poy74fl/Neva/docs/plaque_palpage.jpg

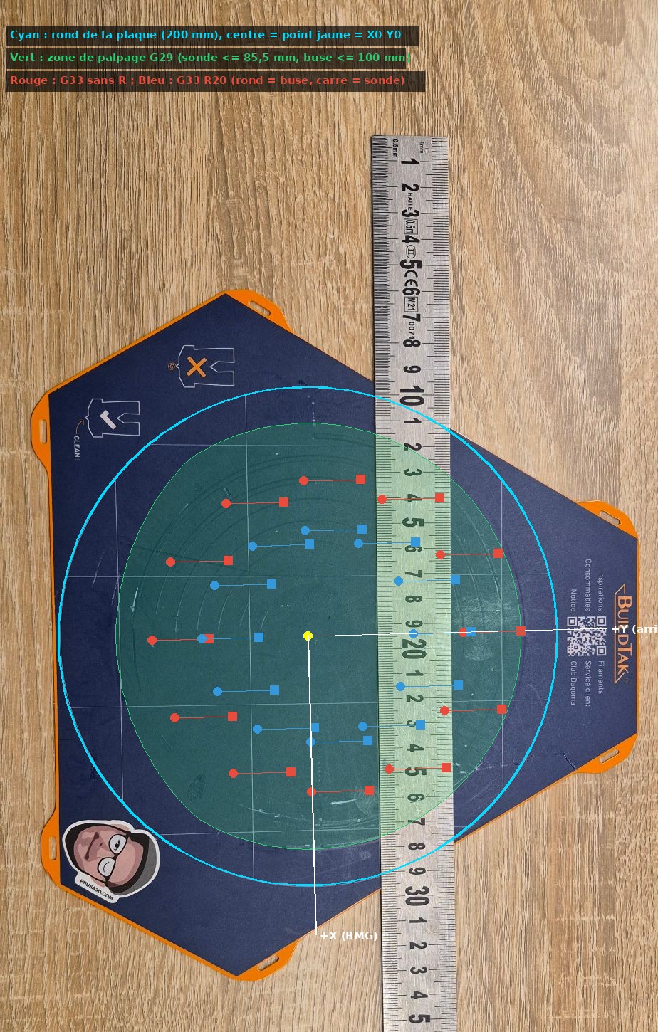
docs/plaque_palpage.jpg
