poy74fl/Neva/docs/superpinda_sur_carte.png

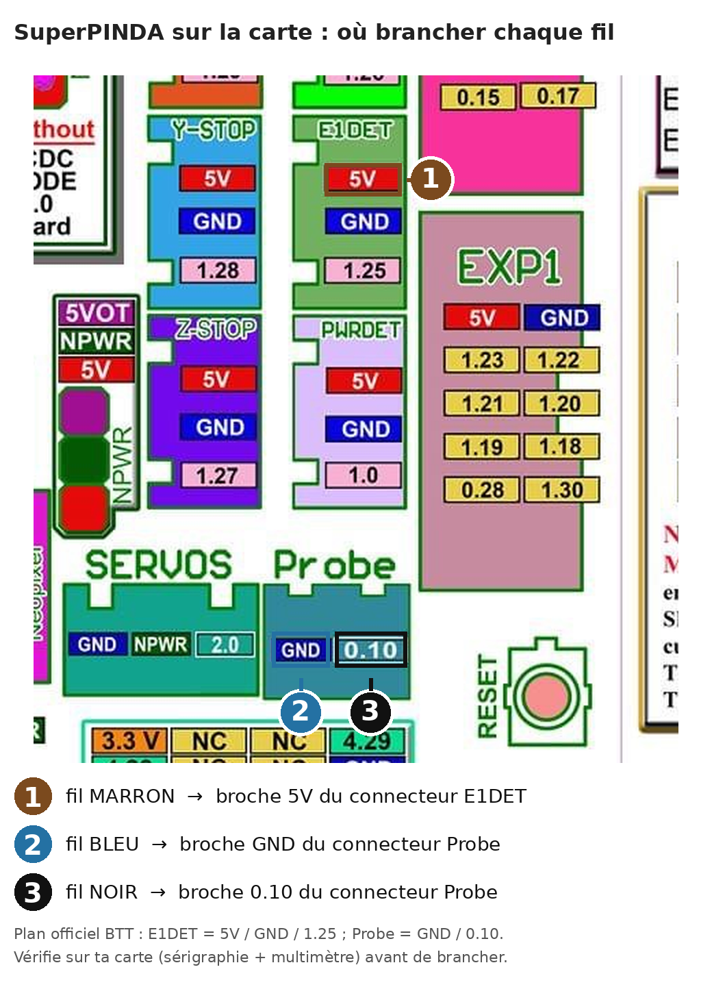
docs/superpinda_sur_carte.png
