poy74fl/Neva/docs/bootscreen_apercu.png

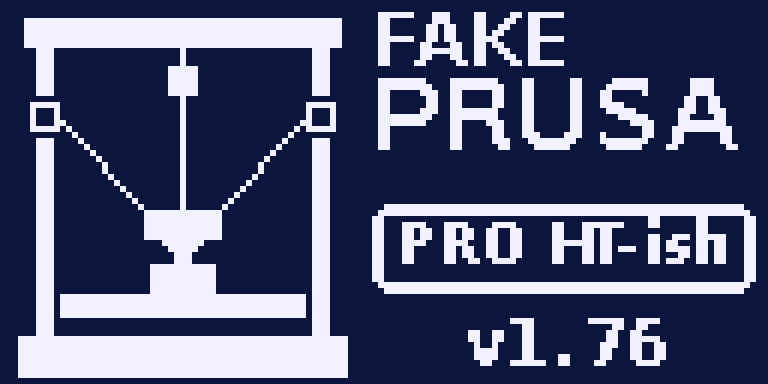
docs/bootscreen_apercu.png
