poy74fl/Neva/docs/mesures_rayon_delta.png

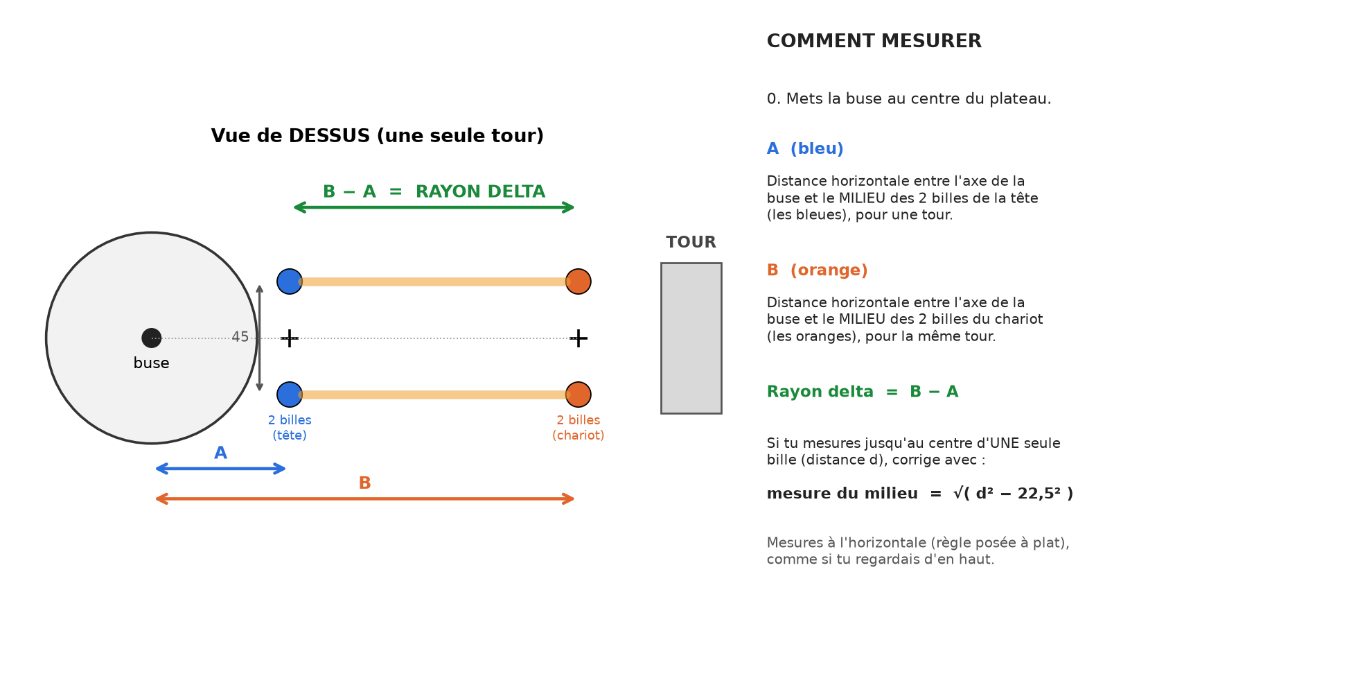
docs/mesures_rayon_delta.png
