poy74fl/Neva/docs/plan_cablage_skr14.png

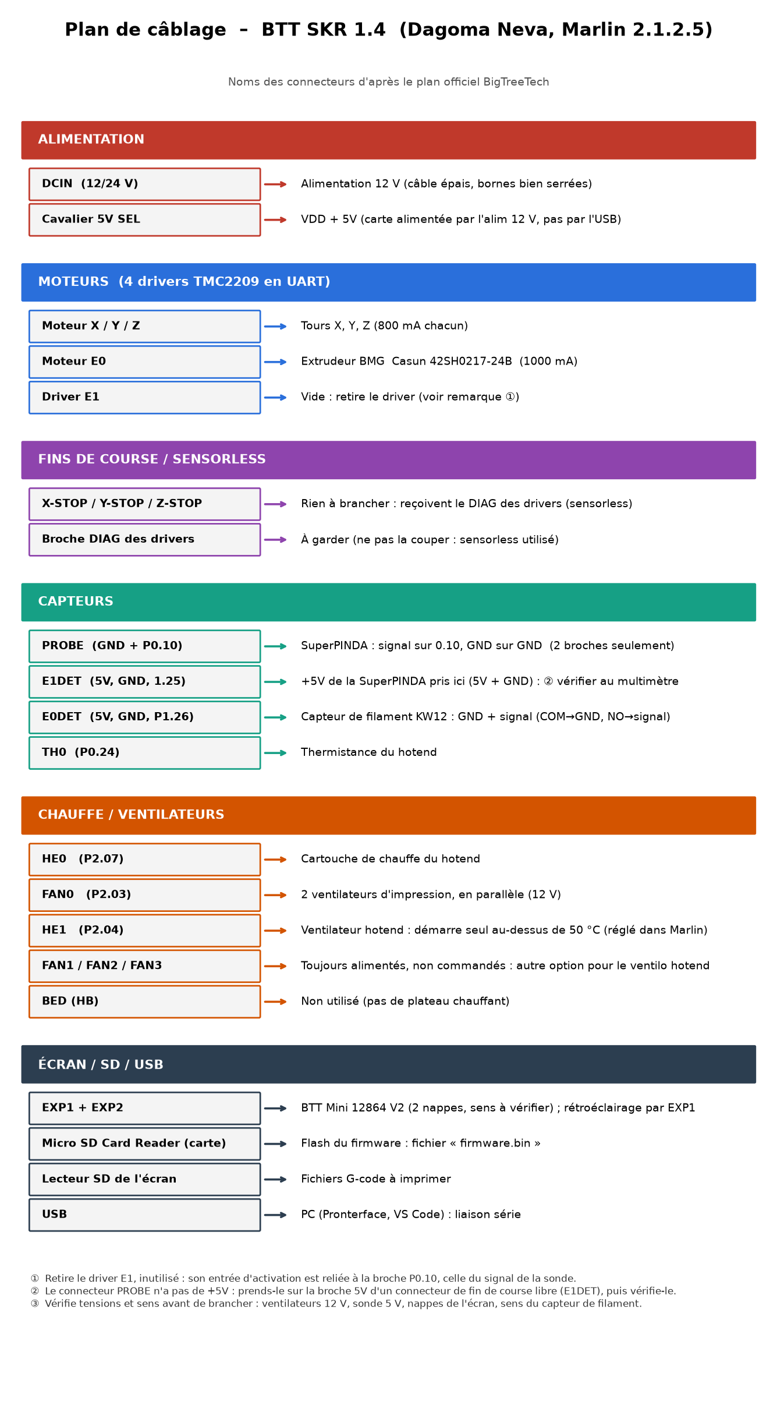
docs/plan_cablage_skr14.png
