poy74fl/Neva/docs/schema_sonde_buse.png

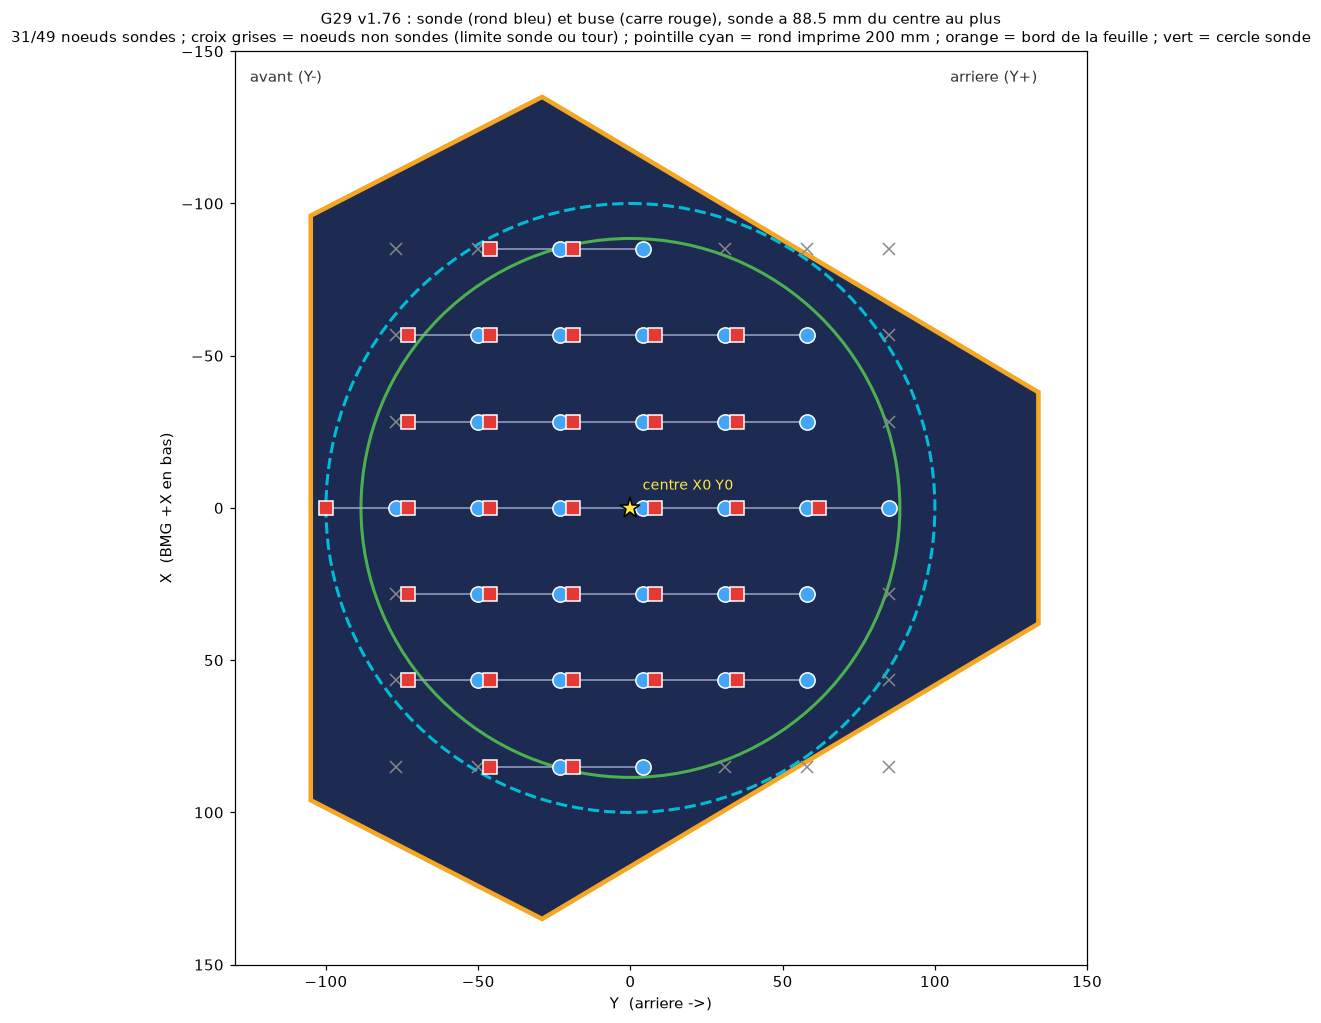
docs/schema_sonde_buse.png
