poy74fl/Neva/docs/schema_superpinda.png

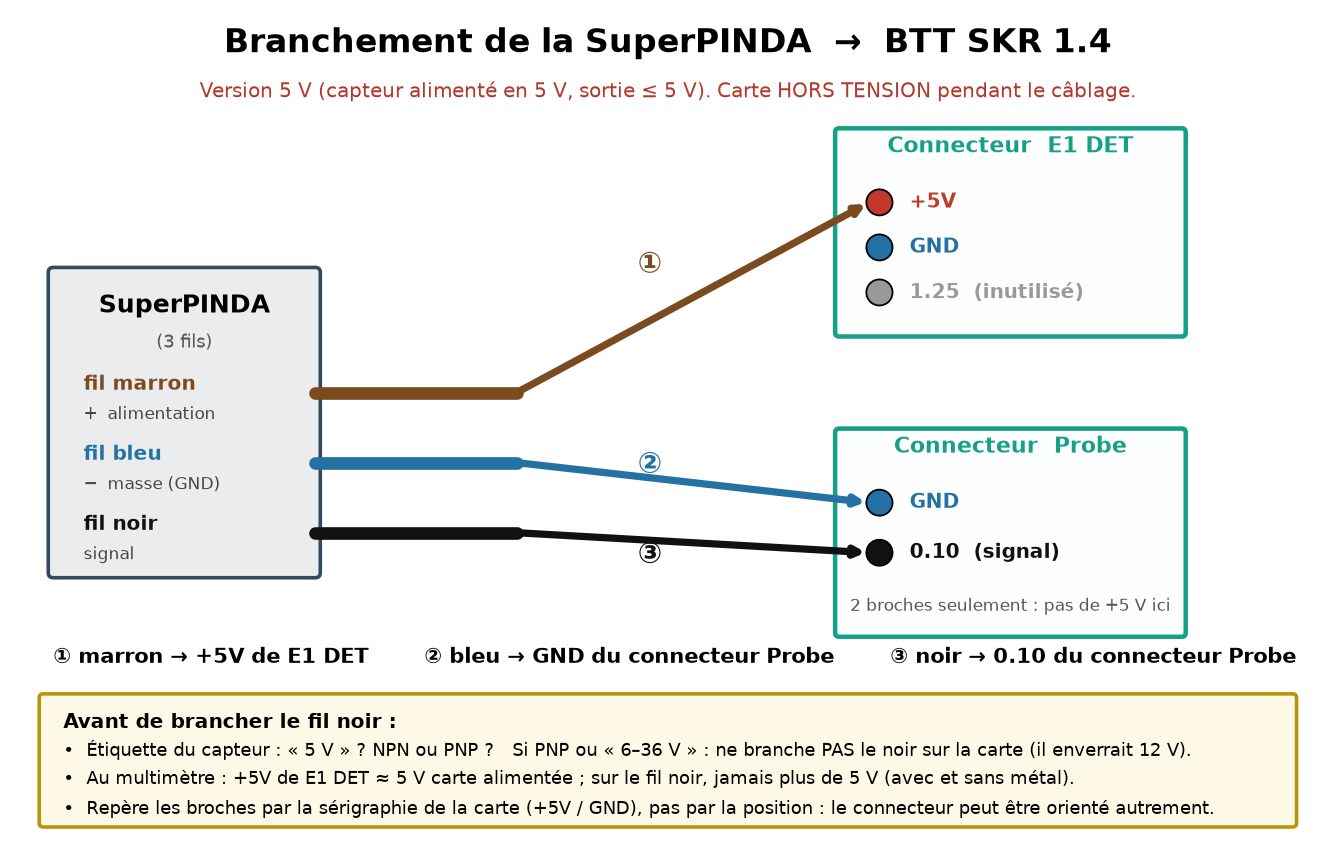
docs/schema_superpinda.png
