poy74fl/Neva/docs/zones_plateau.png

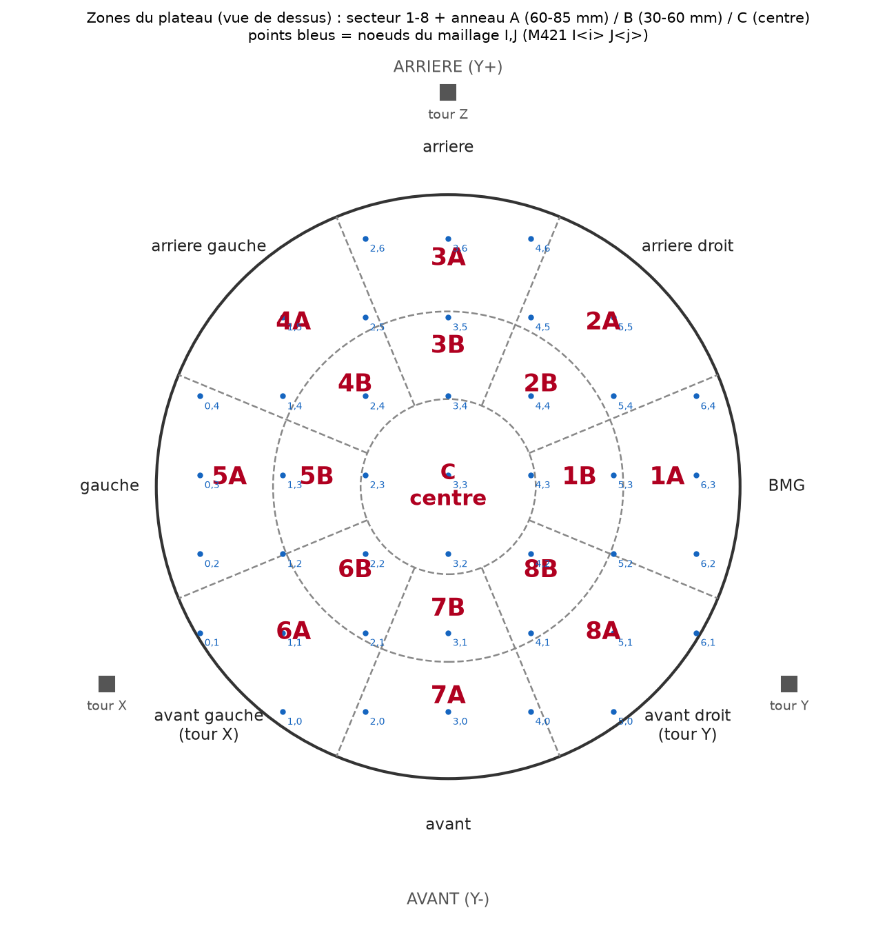
docs/zones_plateau.png
