poy74fl/Neva/docs/test_spirale_apercu.png

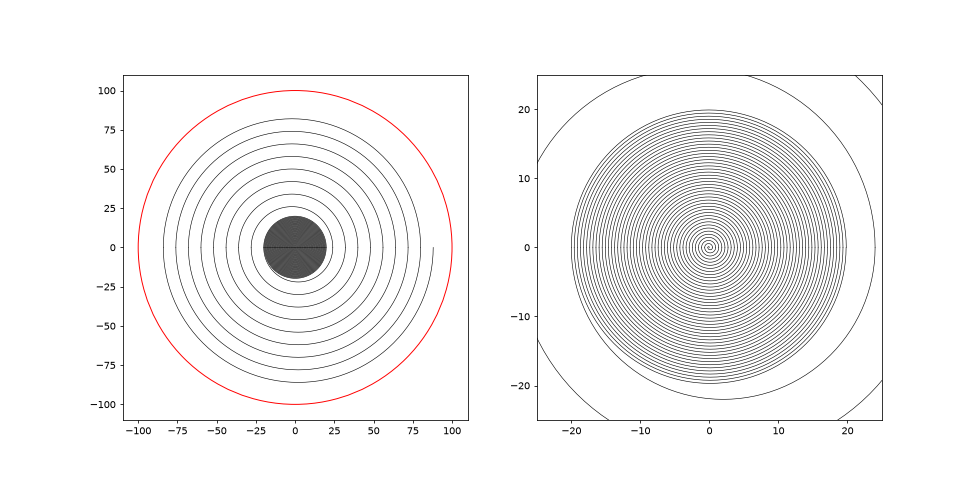
docs/test_spirale_apercu.png
