poy74fl/Neva/marlin-config/Configuration.h

#pragma once
#define CONFIG_EXAMPLES_DIR "delta/generic"
#define CONFIGURATION_H_VERSION 02010205
#define NEVA_FW_VERSION "1.76"
#define STRING_CONFIG_H_AUTHOR "(NEVA-v" NEVA_FW_VERSION ")" // Etiquette visible au demarrage et dans M115 : sert a verifier le firmware flashe
#define SHOW_BOOTSCREEN
#define SHOW_CUSTOM_BOOTSCREEN
  #define MOTHERBOARD BOARD_BTT_SKR_V1_4
#define SERIAL_PORT -1   // USB de la SKR 1.4 (LPC1768)
#define BAUDRATE 115200
#define CUSTOM_MACHINE_NAME "Fake Prusa PRO HT-ish"
#define X_DRIVER_TYPE  TMC2209
#define Y_DRIVER_TYPE  TMC2209
#define Z_DRIVER_TYPE  TMC2209
#define E0_DRIVER_TYPE TMC2209
#define EXTRUDERS 1
#define DEFAULT_NOMINAL_FILAMENT_DIA 1.75
#define TEMP_SENSOR_0 1   // Sonde de la buse sur TH0 : thermistance 100 kohm standard (type 1), temperature correcte verifiee sur la machine
#define TEMP_SENSOR_1 0
#define TEMP_SENSOR_2 0
#define TEMP_SENSOR_3 0
#define TEMP_SENSOR_4 0
#define TEMP_SENSOR_5 0
#define TEMP_SENSOR_6 0
#define TEMP_SENSOR_7 0
#define TEMP_SENSOR_BED 0
#define TEMP_SENSOR_PROBE 0
#define TEMP_SENSOR_CHAMBER 0
#define TEMP_SENSOR_COOLER 0
#define TEMP_SENSOR_BOARD 0
#define TEMP_SENSOR_REDUNDANT 0
#define DUMMY_THERMISTOR_998_VALUE  25
#define DUMMY_THERMISTOR_999_VALUE 100
#if TEMP_SENSOR_IS_MAX_TC(0)
  #define MAX31865_SENSOR_OHMS_0      100 // (Ω) Typically 100 or 1000 (PT100 or PT1000)
  #define MAX31865_CALIBRATION_OHMS_0 430 // (Ω) Typically 430 for Adafruit PT100; 4300 for Adafruit PT1000
#endif
#if TEMP_SENSOR_IS_MAX_TC(1)
  #define MAX31865_SENSOR_OHMS_1      100
  #define MAX31865_CALIBRATION_OHMS_1 430
#endif
#if TEMP_SENSOR_IS_MAX_TC(2)
  #define MAX31865_SENSOR_OHMS_2      100
  #define MAX31865_CALIBRATION_OHMS_2 430
#endif
#if HAS_E_TEMP_SENSOR
  #define TEMP_RESIDENCY_TIME         10  // (seconds) Time to wait for hotend to "settle" in M109
  #define TEMP_WINDOW                  1  // (°C) Temperature proximity for the "temperature reached" timer
  #define TEMP_HYSTERESIS              3  // (°C) Temperature proximity considered "close enough" to the target
#endif
#if TEMP_SENSOR_BED
  #define TEMP_BED_RESIDENCY_TIME      0  // (seconds) Time to wait for bed to "settle" in M190
  #define TEMP_BED_WINDOW              1  // (°C) Temperature proximity for the "temperature reached" timer
  #define TEMP_BED_HYSTERESIS          3  // (°C) Temperature proximity considered "close enough" to the target
#endif
#if TEMP_SENSOR_CHAMBER
  #define TEMP_CHAMBER_RESIDENCY_TIME 10  // (seconds) Time to wait for chamber to "settle" in M191
  #define TEMP_CHAMBER_WINDOW          1  // (°C) Temperature proximity for the "temperature reached" timer
  #define TEMP_CHAMBER_HYSTERESIS      3  // (°C) Temperature proximity considered "close enough" to the target
#endif
#if TEMP_SENSOR_REDUNDANT
  #define TEMP_SENSOR_REDUNDANT_SOURCE    E1  // The sensor that will provide the redundant reading.
  #define TEMP_SENSOR_REDUNDANT_TARGET    E0  // The sensor that we are providing a redundant reading for.
  #define TEMP_SENSOR_REDUNDANT_MAX_DIFF  10  // (°C) Temperature difference that will trigger a print abort.
#endif
#define HEATER_0_MINTEMP   5
#define HEATER_1_MINTEMP   5
#define HEATER_2_MINTEMP   5
#define HEATER_3_MINTEMP   5
#define HEATER_4_MINTEMP   5
#define HEATER_5_MINTEMP   5
#define HEATER_6_MINTEMP   5
#define HEATER_7_MINTEMP   5
#define BED_MINTEMP        5
#define CHAMBER_MINTEMP    5
#define HEATER_0_MAXTEMP 275
#define HEATER_1_MAXTEMP 275
#define HEATER_2_MAXTEMP 275
#define HEATER_3_MAXTEMP 275
#define HEATER_4_MAXTEMP 275
#define HEATER_5_MAXTEMP 275
#define HEATER_6_MAXTEMP 275
#define HEATER_7_MAXTEMP 275
#define BED_MAXTEMP      150
#define CHAMBER_MAXTEMP  60
#define HOTEND_OVERSHOOT 15   // (°C) Forbid temperatures over MAXTEMP - OVERSHOOT
#define BED_OVERSHOOT    10   // (°C) Forbid temperatures over MAXTEMP - OVERSHOOT
#define COOLER_OVERSHOOT  2   // (°C) Forbid temperatures closer than OVERSHOOT
#define PIDTEMP           // See the PID Tuning Guide at https://reprap.org/wiki/PID_Tuning
#define PID_MAX  255      // Limit hotend current while PID is active (see PID_FUNCTIONAL_RANGE below); 255=full current
#define PID_K1     0.95   // Smoothing factor within any PID loop
    #define DEFAULT_Kp  23.00   // PID M303 E0 S200 C8 U1, mesure sur la machine
    #define DEFAULT_Ki   1.76
    #define DEFAULT_Kd  75.01
#define MAX_BED_POWER 255 // limits duty cycle to bed; 255=full current
#define MAX_CHAMBER_POWER 255 // limits duty cycle to chamber heater; 255=full current
  #define PID_FUNCTIONAL_RANGE 10 // If the temperature difference between the target temperature and the actual temperature
  #define PID_EDIT_MENU         // Add PID editing to the "Advanced Settings" menu. (~700 bytes of flash)
  #define PID_AUTOTUNE_MENU     // Add PID auto-tuning to the "Advanced Settings" menu. (~250 bytes of flash)
#define PREVENT_COLD_EXTRUSION
#define EXTRUDE_MINTEMP 170
#define PREVENT_LENGTHY_EXTRUDE
#define EXTRUDE_MAXLENGTH 1100   // Bowden de 870 mm : doit etre >= longueurs de chargement/dechargement (1000)
#define THERMAL_PROTECTION_HOTENDS // Enable thermal protection for all extruders
#define THERMAL_PROTECTION_BED     // Enable thermal protection for the heated bed
#define THERMAL_PROTECTION_CHAMBER // Enable thermal protection for the heated chamber
#define THERMAL_PROTECTION_COOLER  // Enable thermal protection for the laser cooling
#define DELTA
  #define DEFAULT_SEGMENTS_PER_SECOND 200
  #define DELTA_CALIBRATION_MENU
  #define DELTA_AUTO_CALIBRATION   // G33 (necessite la sonde)
    #define DELTA_CALIBRATION_DEFAULT_POINTS 4
    #define PROBE_MANUALLY_STEP 0.05      // (mm)
  #define DELTA_PRINTABLE_RADIUS 100.0    // (mm) zone demandee : diametre 200. ATTENTION : au-dela de ~60 mm la tete peut toucher les tours (a tester a la main)
  #define DELTA_MAX_RADIUS       100.0    // (mm) voir DELTA_PRINTABLE_RADIUS
  #define DELTA_DIAGONAL_ROD     200.6    // (mm) entraxe des rotules : tube 210 - 2 x 4.7 (centre de rotule a 4.7 mm du bout)
  #define DELTA_HEIGHT           312.22   // (mm) 312.42 - 0.2 (buse relevee de 0.2 mm au reglage de la 1re couche). Recale par G33 P1 avant chaque impression
  #define DELTA_ENDSTOP_ADJ { 0.0, -0.93, -5.74 } // (mm) M666 apres G33. Z tres decale : butee sensorless des tours pas a la meme hauteur
  #define DELTA_RADIUS            91.68   // (mm) resultat G33 (mesure initiale : 97, B 135 - A 38)
  #define DELTA_TOWER_ANGLE_TRIM { -0.28, 0.56, -0.28 } // M665 X Y Z apres G33
#define USE_ZMIN_PLUG // a Z probe
#define USE_XMAX_PLUG
#define USE_YMAX_PLUG
#define USE_ZMAX_PLUG
#define ENDSTOPPULLUPS
#define X_MIN_ENDSTOP_INVERTING true  // Set to true to invert the logic of the endstop.
#define Y_MIN_ENDSTOP_INVERTING true  // Set to true to invert the logic of the endstop.
#define Z_MIN_ENDSTOP_INVERTING true  // Set to true to invert the logic of the endstop.
#define I_MIN_ENDSTOP_INVERTING false // Set to true to invert the logic of the endstop.
#define J_MIN_ENDSTOP_INVERTING false // Set to true to invert the logic of the endstop.
#define K_MIN_ENDSTOP_INVERTING false // Set to true to invert the logic of the endstop.
#define U_MIN_ENDSTOP_INVERTING false // Set to true to invert the logic of the endstop.
#define V_MIN_ENDSTOP_INVERTING false // Set to true to invert the logic of the endstop.
#define W_MIN_ENDSTOP_INVERTING false // Set to true to invert the logic of the endstop.
#define X_MAX_ENDSTOP_INVERTING false // Sensorless TMC2209 : DIAG = HIGH au decrochage
#define Y_MAX_ENDSTOP_INVERTING false // Sensorless TMC2209 : DIAG = HIGH au decrochage
#define Z_MAX_ENDSTOP_INVERTING false // Sensorless TMC2209 : DIAG = HIGH au decrochage
#define I_MAX_ENDSTOP_INVERTING false // Set to true to invert the logic of the endstop.
#define J_MAX_ENDSTOP_INVERTING false // Set to true to invert the logic of the endstop.
#define K_MAX_ENDSTOP_INVERTING false // Set to true to invert the logic of the endstop.
#define U_MAX_ENDSTOP_INVERTING false // Set to true to invert the logic of the endstop.
#define V_MAX_ENDSTOP_INVERTING false // Set to true to invert the logic of the endstop.
#define W_MAX_ENDSTOP_INVERTING false // Set to true to invert the logic of the endstop.
#define Z_MIN_PROBE_ENDSTOP_INVERTING false  // SuperPINDA : verifie avec M119 (TRIGGERED seulement pres d'un metal)
#define XYZ_FULL_STEPS_PER_ROTATION 200
#define XYZ_MICROSTEPS 16
#define XYZ_BELT_PITCH 2
#define XYZ_PULLEY_TEETH 20   // Poulies 20 dents -> 80 pas/mm (mesure : la machine descend 1.25x trop avec 16 dents)
#define DEFAULT_XYZ_STEPS_PER_UNIT ((XYZ_FULL_STEPS_PER_ROTATION) * (XYZ_MICROSTEPS) / double(XYZ_BELT_PITCH) / double(XYZ_PULLEY_TEETH))
#define DEFAULT_AXIS_STEPS_PER_UNIT   { DEFAULT_XYZ_STEPS_PER_UNIT, DEFAULT_XYZ_STEPS_PER_UNIT, DEFAULT_XYZ_STEPS_PER_UNIT, 415 }  // E0 : BMG 3:1, moteur 1.8 deg, 16 micropas = 415 (830 si moteur 0.9 deg)
#define DEFAULT_MAX_FEEDRATE          { 200, 200, 200, 60 }   // E a 60 mm/s : necessaire pour le chargement/dechargement rapide (50 mm/s)
#define DEFAULT_MAX_ACCELERATION      { 3000, 3000, 3000, 5000 }
#define DEFAULT_ACCELERATION          3000    // X, Y, Z and E acceleration for printing moves
#define DEFAULT_RETRACT_ACCELERATION  3000    // E acceleration for retracts
#define DEFAULT_TRAVEL_ACCELERATION   3000    // X, Y, Z acceleration for travel (non printing) moves
#define CLASSIC_JERK
  #define DEFAULT_XJERK 10.0
  #define DEFAULT_YJERK DEFAULT_XJERK
  #define DEFAULT_ZJERK DEFAULT_XJERK // Must be same as XY for delta
#define DEFAULT_EJERK   10.0  // Doit etre >= 10 avec LIN_ADVANCE (Bowden)
#define S_CURVE_ACCELERATION
#define FIX_MOUNTED_PROBE   // Sonde PINDA fixee sur la tete
#define NOZZLE_TO_PROBE_OFFSET { 0, 23, -1.233 } // X, Y mesures : PINDA derriere la buse (+Y = vers la tour Z). Z = reglage de la 1re couche (double-clic molette) : -1.233 (valeur choisie par l'utilisateur apres la validation des M421 a -1.195)
#define NEVA_PLATE_RADIUS    100.0 // Rond imprime : 200 mm de diametre, centre = X0 Y0 (centre valide par l'utilisateur)
#define NEVA_PLATE_FLAT_MIN  103.0 // Distance du centre au bord plat le plus proche de la plaque (103 a 108 mm selon le cote)
#define NEVA_PROBE_MAX_RADIUS 88.5 // Rayon MAX de la SONDE (mm), choisi par l'utilisateur (cercle de 88 mm + noeud X+-85 Y-23 a 88,06 mm). Les noeuds a 89,6 mm (X+-28 Y85) et 90,5 mm (X-85 Y31) restent exclus.
#define PROBING_MARGIN (DELTA_PRINTABLE_RADIUS - NEVA_PROBE_MAX_RADIUS) // = 11,5 mm : la sonde ne sort pas de NEVA_PROBE_MAX_RADIUS
#define NEVA_MESH_SHIFT   // Neva : applique le maillage avec le decalage de la sonde (23 mm) ; commenter la ligne pour revenir a l'ancien comportement
#define NEVA_MESH_MARGIN 15 // Neva : le maillage G29 couvre un disque de 100 - 15 = 85 mm (avant 77). Sondes ecartees automatiquement si la buse ne peut pas les atteindre (avant).
#define XY_PROBE_FEEDRATE (66*60)
#define Z_PROBE_FEEDRATE_FAST (30*60)   // Neva : etait 200 mm/s ; une approche trop rapide fait bouger la tete et fausse le palpage
#define Z_PROBE_FEEDRATE_SLOW (8*60)    // Neva : 8 mm/s pour la mesure finale (5 mm/s en v1.43-v1.57, 100 mm/s avant) : palpage plus rapide
#define MULTIPLE_PROBING 2 // Neva v1.63 : 1 approche rapide + 1 mesure lente par point (avant 3 : 2 mesures lentes moyennees) pour accelerer G29 et G33
#define Z_CLEARANCE_DEPLOY_PROBE   15 // (mm) Z Clearance for Deploy/Stow
#define Z_CLEARANCE_BETWEEN_PROBES  5 // (mm) Z Clearance between probe points
#define Z_CLEARANCE_MULTI_PROBE     3 // (mm) Z Clearance between multiple probes (Neva : 3 au lieu de 5, descente lente plus courte)
#define Z_AFTER_PROBING           30 // (mm) Neva v1.63 : la tete remonte a 30 mm a la fin de G29 (avant : restait a 5 mm)
#define Z_PROBE_LOW_POINT          -2 // (mm) Farthest distance below the trigger-point to go before stopping
#define Z_PROBE_OFFSET_RANGE_MIN -20
#define Z_PROBE_OFFSET_RANGE_MAX 20
#define X_ENABLE_ON 0
#define Y_ENABLE_ON 0
#define Z_ENABLE_ON 0
#define E_ENABLE_ON 0 // For all extruders
#define DISABLE_OTHER_EXTRUDERS   // Keep only the active extruder enabled
#define INVERT_X_DIR false
#define INVERT_Y_DIR false
#define INVERT_Z_DIR false
#define INVERT_E0_DIR true   // Extrudeur BMG + Casun : le filament reculait avec false (verifie sur la machine)
#define INVERT_E1_DIR false
#define INVERT_E2_DIR false
#define INVERT_E3_DIR false
#define INVERT_E4_DIR false
#define INVERT_E5_DIR false
#define INVERT_E6_DIR false
#define INVERT_E7_DIR false
#define X_HOME_DIR 1  // deltas always home to max
#define Y_HOME_DIR 1
#define Z_HOME_DIR 1
#define X_BED_SIZE ((DELTA_PRINTABLE_RADIUS) * 2)
#define Y_BED_SIZE ((DELTA_PRINTABLE_RADIUS) * 2)
#define X_MIN_POS -(DELTA_PRINTABLE_RADIUS)
#define Y_MIN_POS -(DELTA_PRINTABLE_RADIUS)
#define Z_MIN_POS 0
#define X_MAX_POS DELTA_PRINTABLE_RADIUS
#define Y_MAX_POS DELTA_PRINTABLE_RADIUS
#define Z_MAX_POS MANUAL_Z_HOME_POS
#define MIN_SOFTWARE_ENDSTOPS
  #define MIN_SOFTWARE_ENDSTOP_X
  #define MIN_SOFTWARE_ENDSTOP_Y
  #define MIN_SOFTWARE_ENDSTOP_Z
  #define MIN_SOFTWARE_ENDSTOP_I
  #define MIN_SOFTWARE_ENDSTOP_J
  #define MIN_SOFTWARE_ENDSTOP_K
  #define MIN_SOFTWARE_ENDSTOP_U
  #define MIN_SOFTWARE_ENDSTOP_V
  #define MIN_SOFTWARE_ENDSTOP_W
#define MAX_SOFTWARE_ENDSTOPS
  #define MAX_SOFTWARE_ENDSTOP_X
  #define MAX_SOFTWARE_ENDSTOP_Y
  #define MAX_SOFTWARE_ENDSTOP_Z
  #define MAX_SOFTWARE_ENDSTOP_I
  #define MAX_SOFTWARE_ENDSTOP_J
  #define MAX_SOFTWARE_ENDSTOP_K
  #define MAX_SOFTWARE_ENDSTOP_U
  #define MAX_SOFTWARE_ENDSTOP_V
  #define MAX_SOFTWARE_ENDSTOP_W
#define FILAMENT_RUNOUT_SENSOR   // Capteur KW12 sur le port E0-DET de la SKR 1.4 (P1.26), voir README
  #define FIL_RUNOUT_ENABLED_DEFAULT true // Enable the sensor on startup. Override with M412 followed by M500.
  #define NUM_RUNOUT_SENSORS   1          // Number of sensors, up to one per extruder. Define a FIL_RUNOUT#_PIN for each.
  #define FIL_RUNOUT_STATE     HIGH       // Etat de la broche = PLUS de filament. KW12 cable COM->GND, NO->signal + pull-up : sans filament la broche est a HIGH. NB : M119 affiche "filament: TRIGGERED" quand le filament est PRESENT, "open" quand il manque
  #define FIL_RUNOUT_PULLUP               // Use internal pullup for filament runout pins.
  #define FILAMENT_RUNOUT_SCRIPT "M600"
  #define FILAMENT_RUNOUT_DISTANCE_MM 90   // Neva : capteur 100 mm avant l extrudeur : on continue 90 mm apres detection, la fin du filament est alors encore dans l extrudeur au moment de la pause
#define AUTO_BED_LEVELING_BILINEAR   // Neva : maillage du plateau (G29), lance avant chaque impression apres G28 + G33 P1
  #define ENABLE_LEVELING_FADE_HEIGHT // Neva v1.65 : la correction du maillage s'estompe jusqu'a 10 mm de hauteur (M420 Z<h> pour changer)
    #define DEFAULT_LEVELING_FADE_HEIGHT 10.0 // (mm) Default fade height.
  #define SEGMENT_LEVELED_MOVES
  #define LEVELED_SEGMENT_LENGTH 5.0 // (mm) Length of all segments (except the last one)
  #define GRID_MAX_POINTS_X 7    // Neva : grille 7 x 7, seuls les points dans le disque palpable sont mesures (environ 30 points)
  #define GRID_MAX_POINTS_Y GRID_MAX_POINTS_X
#define BED_CENTER_AT_0_0
#define MANUAL_Z_HOME_POS DELTA_HEIGHT // Distance between the nozzle to printbed after homing
#define HOMING_FEEDRATE_MM_M { (50*60), (50*60), (50*60) }  // 50 mm/s
#define VALIDATE_HOMING_ENDSTOPS
#define EEPROM_SETTINGS     // Persistent storage with M500 and M501
#define EEPROM_CHITCHAT       // Give feedback on EEPROM commands. Disable to save flash.
#define EEPROM_BOOT_SILENT    // Keep M503 quiet and only give errors during first load
#define HOST_KEEPALIVE_FEATURE        // Disable this if your host doesn't like keepalive messages
#define DEFAULT_KEEPALIVE_INTERVAL 2  // Number of seconds between "busy" messages. Set with M113.
#define BUSY_WHILE_HEATING            // Some hosts require "busy" messages even during heating
#define PREHEAT_1_LABEL       "PLA"
#define PREHEAT_1_TEMP_HOTEND 210
#define PREHEAT_1_TEMP_BED     70
#define PREHEAT_1_TEMP_CHAMBER 35
#define PREHEAT_1_FAN_SPEED   255 // Value from 0 to 255
#define PREHEAT_2_LABEL       "PETG"
#define PREHEAT_2_TEMP_HOTEND 230
#define PREHEAT_2_TEMP_BED    100
#define PREHEAT_2_TEMP_CHAMBER 35
#define PREHEAT_2_FAN_SPEED   255 // Value from 0 to 255
#define NOZZLE_PARK_FEATURE
  #define NOZZLE_PARK_POINT { (X_MIN_POS + 10), 0, 20 }
  #define NOZZLE_PARK_MOVE          0   // Park motion: 0 = XY Move, 1 = X Only, 2 = Y Only, 3 = X before Y, 4 = Y before X
  #define NOZZLE_PARK_Z_RAISE_MIN   2   // (mm) Always raise Z by at least this distance
  #define NOZZLE_PARK_XY_FEEDRATE 100   // (mm/s) X and Y axes feedrate (also used for delta Z axis)
  #define NOZZLE_PARK_Z_FEEDRATE    5   // (mm/s) Z axis feedrate (not used for delta printers)
#define PRINTJOB_TIMER_AUTOSTART
#define PRINTCOUNTER   // Statistiques d'impression (temps, filament, nombre) : affichees dans Infos imprimante
  #define PRINTCOUNTER_SAVE_INTERVAL 60 // (minutes) EEPROM save interval during print. A value of 0 will save stats at end of print.
#define LCD_LANGUAGE fr
#define DISPLAY_CHARSET_HD44780 JAPANESE
#define LCD_INFO_SCREEN_STYLE 0
#define SDSUPPORT   // Avec un ecran, la SKR 1.4 utilise par defaut la SD de l'ecran (SDCARD_CONNECTION LCD)
#define BTT_MINI_12864   // Ecran BTT Mini 12864 V2, nappes sur EXP1 + EXP2
#define SOFT_PWM_SCALE 0
#define NEOPIXEL_LED   // Retroeclairage RGB du BTT Mini 12864 V2
  #define NEOPIXEL_TYPE          NEO_RGB  // Impose par le BTT Mini 12864
  #define NEOPIXEL_PIXELS               3 // 3 LED sur l'ecran
  #define NEOPIXEL_IS_SEQUENTIAL          // Sequential display for temperature change - LED by LED. Disable to change all LEDs at once.
  #define NEOPIXEL_BRIGHTNESS         255 // Luminosite initiale (0-255)
  #define PRINTER_EVENT_LEDS
#define SERVO_DELAY { 300 }
