poy74fl/Neva/marlin-config/Configuration_adv.h

#define E0_AUTO_FAN_PIN FAN1_PIN   // Ventilo hotend : auto au-dessus de 50 C, sortie FAN1
#define E1_AUTO_FAN_PIN -1
#define E2_AUTO_FAN_PIN -1
#define E3_AUTO_FAN_PIN -1
#define E4_AUTO_FAN_PIN -1
#define E5_AUTO_FAN_PIN -1
#define E6_AUTO_FAN_PIN -1
#define E7_AUTO_FAN_PIN -1
#define CHAMBER_AUTO_FAN_PIN -1
#define COOLER_AUTO_FAN_PIN -1
#define HOMING_BUMP_MM      { 3, 3, 3 }       // (linear=mm, rotational=°) Recul apres le 1er contact, puis 2e contact plus lent
#define HOMING_BUMP_DIVISOR { 2, 2, 2 }       // Vitesse du 2e contact = vitesse de homing / 2 (25 mm/s : detection sensorless fiable)
#define MICROSTEP_MODES { 16, 16, 16, 16, 16, 16 } // [1,2,4,8,16]
#define LIN_ADVANCE
    #define ADVANCE_K 0.22        // (mm) Compression length applying to all extruders
#define ADVANCED_PAUSE_FEATURE
  #define ADVANCED_PAUSE_PURGE_FEEDRATE        3  // (mm/s) Extrude feedrate (after loading). Should be slower than load feedrate.
  #define ADVANCED_PAUSE_PURGE_LENGTH         50  // (mm) Length to extrude after loading.
  #define ADVANCED_PAUSE_RESUME_PRIME          0  // (mm) Extra distance to prime nozzle after returning from park.
    #define X_CURRENT       800        // (mA) RMS current. Multiply by 1.414 for peak current.
    #define X_CURRENT_HOME  X_CURRENT  // (mA) RMS current for homing. (Typically lower than *_CURRENT.)
    #define X_MICROSTEPS     16        // 0..256
    #define Y_CURRENT       800
    #define Y_CURRENT_HOME  Y_CURRENT
    #define Y_MICROSTEPS     16
    #define Z_CURRENT       800
    #define Z_CURRENT_HOME  Z_CURRENT
    #define Z_MICROSTEPS     16
    #define E0_CURRENT     1000  // (mA) RMS : moteur Casun 42SH0217-24B, 1.5 A nominal -> ~0.7 x 1.5 A
    #define E0_MICROSTEPS    16
  #define X_HYBRID_THRESHOLD     100  // [mm/s]
  #define X2_HYBRID_THRESHOLD    100
  #define Y_HYBRID_THRESHOLD     100
  #define Y2_HYBRID_THRESHOLD    100
  #define Z_HYBRID_THRESHOLD       3
  #define Z2_HYBRID_THRESHOLD      3
  #define Z3_HYBRID_THRESHOLD      3
  #define Z4_HYBRID_THRESHOLD      3
  #define I_HYBRID_THRESHOLD       3  // [linear=mm/s, rotational=°/s]
  #define J_HYBRID_THRESHOLD       3  // [linear=mm/s, rotational=°/s]
  #define K_HYBRID_THRESHOLD       3  // [linear=mm/s, rotational=°/s]
  #define U_HYBRID_THRESHOLD       3  // [mm/s]
  #define V_HYBRID_THRESHOLD       3
  #define W_HYBRID_THRESHOLD       3
  #define E0_HYBRID_THRESHOLD     30
  #define E1_HYBRID_THRESHOLD     30
  #define E2_HYBRID_THRESHOLD     30
  #define E3_HYBRID_THRESHOLD     30
  #define E4_HYBRID_THRESHOLD     30
  #define E5_HYBRID_THRESHOLD     30
  #define E6_HYBRID_THRESHOLD     30
  #define E7_HYBRID_THRESHOLD     30
  #define SENSORLESS_HOMING // Homing sensorless en haut des tours X, Y, Z (DIAG sur X/Y/Z-STOP)
    #define X_STALL_SENSITIVITY  75  // regle sur la machine avec la tete (50 mm/s)
    #define X2_STALL_SENSITIVITY X_STALL_SENSITIVITY
    #define Y_STALL_SENSITIVITY  75  // regle sur la machine avec la tete (50 mm/s)
    #define Y2_STALL_SENSITIVITY Y_STALL_SENSITIVITY
    #define Z_STALL_SENSITIVITY  75  // regle sur la machine avec la tete (50 mm/s)
    #define IMPROVE_HOMING_RELIABILITY
