poy74fl/Neva/(commit log)

2026-10-01 Marlin 2.1.2.5 config for Dagoma Neva on BTT SKR Mini E3 V3.0
    Starting point derived from the generic delta example; Neva-specific
    values are marked NEVA: and still need to be checked against the old
    firmware. Not compiled yet.
    Claude-Session: https://claude.ai/code/session_012EdznbhRS4ubS7iXg3NmBm
    [Configuration.h, Configuration_adv.h]
2026-10-01 Enable MKS Mini 12864 V3 display and onboard SD
    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
    [Configuration.h]
2026-10-01 Fix SD comments: screen SD slot unsupported on SKR Mini E3 V3
    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
    [Configuration.h]
2026-10-01 Dual fans: part cooling on FAN0, hotend fan automatic on FAN1
    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
    [Configuration_adv.h]
2026-10-01 Add inductive probe on PROBE port with G33 delta calibration
    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
    [Configuration.h]
2026-10-01 Document PINDA probe wiring and caveats
    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
2026-10-01 Switch target board to BTT SKR 1.4 (LPC1768) with TMC2209 and EXP1/EXP2 display
    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
    [Configuration.h]
2026-10-12 Switch display to BTT Mini 12864 V2
    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
2026-10-13 Sensorless homing on delta towers, BMG extruder steps
    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
2026-10-13 Add filament runout sensor with M600 and nozzle park
    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
2026-10-13 Runout sensor: KW12 microswitch wiring (COM+NO), FIL_RUNOUT_STATE HIGH
    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
2026-10-13 Rebuild configs on official Marlin 2.1.2.5 base (fix #error and version mismatch)
    The previous files came from the import-2.1.x configurations branch and
    contained a hard #error. Rebased all settings onto the 2.1.2.5 tag
    (INVERTING instead of HIT_STATE, DELTA_PRINTABLE_RADIUS, EXTRUDE_MAXLENGTH
    raised to cover the Bowden unload length).
    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
2026-10-13 Slow homing feedrate to 30 mm/s
    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
2026-10-13 Restore homing feedrate to 50 mm/s
    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
2026-10-13 Set sensorless sensitivity X65 Y90 Z65 (tuned on machine)
    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
2026-10-13 Sensorless sensitivity X/Y/Z = 92 (tuned on machine)
    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
2026-10-13 Sensorless sensitivity X85 Y90 Z85 (tuned on machine)
    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
2026-10-13 Sensorless sensitivity X/Y/Z = 75 (tuned with head mounted)
    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
2026-10-13 Homing: double contact (bump 3 mm, speed divisor 2)
    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
2026-10-13 Set DELTA_DIAGONAL_ROD to 210 mm (measured)
    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
2026-10-13 DELTA_DIAGONAL_ROD 210.6 mm (center-to-center from tube 210 + ball geometry)
    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
2026-10-13 DELTA_DIAGONAL_ROD 200.6 mm (ball centers 4.7 mm inside each tube end)
    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
2026-10-13 Delta radius 72 mm (B-A measured), provisional printable radius 40 mm
    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
2026-10-13 Delta radius 97 mm (B=135, A=38), provisional printable radius 60 mm
    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
2026-10-13 Printable radius 100 mm (200 mm diameter) as requested
    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
2026-10-13 DELTA_HEIGHT 320 mm (measured nozzle-to-bed after G28)
    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
2026-10-13 Probe offset X0 Y+23 (PINDA behind nozzle)
    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
2026-10-13 Bowden 1100 mm: filament change lengths/feedrates and EXTRUDE_MAXLENGTH
    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
2026-10-13 E0 current 1000 mA for Casun 42SH0217-24B extruder motor
    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
2026-10-13 Add motion test G-code (no heating, no extrusion)
    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
2026-10-13 Reorder main menu (patch), rename Temperature->Prechauffage, disable PSU_CONTROL
    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
2026-10-13 Menu labels like Prusa: 'Impr. depuis la SD'
    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
2026-10-14 Re-enable info menu (printer info, board, thermistors, stats) as last main menu item; PRINTCOUNTER on
    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
2026-10-14 Enable selected options: TMC_DEBUG, driver monitor, babystepping, probe wizard, multiple probing, load/unload, PID menus, remaining time, S-curve, linear advance, fan kickstart
    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
2026-10-14 Add SKR 1.4 wiring plan diagram
    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
2026-10-14 Fix wiring plan using official BTT pin map (TH0, PROBE has no 5V, FAN1-3 always on)
    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
2026-10-14 Add SuperPINDA wiring diagram
    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
2026-10-14 Add SuperPINDA-on-board wiring image
    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
2026-10-14 Probe signal inverted: Z_MIN_PROBE_ENDSTOP_INVERTING false
    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
2026-10-14 Pulleys 20 teeth (80 steps/mm): tower travel was 1.25x too large with 16 teeth
    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
2026-10-14 Calibration G33: DELTA_HEIGHT 312.45, RADIUS 91.68, ENDSTOP_ADJ, TOWER_ANGLE_TRIM, sonde Z -2.4
    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
2026-10-14 DELTA_HEIGHT 312.42 (G33 P1, buse sur le plateau a Z0)
    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
2026-10-14 Calibration finale (M503): M666 0/-0.93/-5.74, angles tours -0.28/0.56/-0.28
    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
2026-10-14 Logo de demarrage personnalise (SHOW_CUSTOM_BOOTSCREEN) + generateur
    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
2026-10-14 Logo de demarrage: fake Prusa PRO HT90 (option --neva pour l'ancien)
    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
2026-10-14 Logo de demarrage: ajoute la machine (delta) a cote de PRUSA PRO HT90
    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
2026-10-14 Logo de demarrage: FAKE PRUSA PRO HT00
    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
2026-10-14 Logo de demarrage: ajoute le numero de version du firmware
    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
2026-10-14 Version du firmware Neva (NEVA_FW_VERSION) affichee sur l'ecran de controle au demarrage
    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
2026-10-14 Message de demarrage: Fake Prusa fw vX
    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
2026-10-14 Attenuation automatique du retroeclairage apres inactivite (patch marlinui.cpp), firmware v1.2
    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
2026-10-14 G-code d'animation de chauffe (tete de gauche a droite)
    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
2026-10-14 Supprime l'ecran de demarrage Marlin apres le logo perso (patch marlinui_DOGM.cpp), firmware v1.5
    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
2026-10-14 Fin d'impression: vert sans limite de temps, moteurs maintenus (delta), firmware v1.6
    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
2026-10-14 FIL_RUNOUT_STATE LOW (capteur KW12 mesure : open sans filament), firmware v1.7
    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
2026-10-14 TEMP_SENSOR_0 1 (thermistance 100k: temperature correcte avant, MAXTEMP avec 1047), firmware v1.8
    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
2026-10-14 PID buse mesure (Kp 23.00 Ki 1.76 Kd 75.01), firmware v1.9
    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
2026-10-14 Bowden 870 mm: unload 920, fast load 870, EXTRUDE_MAXLENGTH 1000, firmware v1.10
    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
2026-10-14 Capteur de filament a 100 mm de l'extrudeur: FILAMENT_RUNOUT_DISTANCE_MM 90, firmware v1.11
    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
2026-10-14 Bloque le lancement d'une impression SD sans filament (patch M24), firmware v1.12
    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
2026-10-14 G-code de test du filament (extrusion mesuree)
    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
2026-10-14 FIL_RUNOUT_STATE HIGH (M119 TRIGGERED = filament present), corrige le blocage sans filament, firmware v1.13
    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
2026-10-14 INVERT_E0_DIR true (le filament reculait en extrusion), firmware v1.14
    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
2026-10-14 Chargement/dechargement filament a 50 mm/s (accel 50), vitesse max E 60, firmware v1.16
    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
2026-10-14 G-code de test de premiere couche (carre 60x60, sans ventilateur)
    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
2026-10-14 Chargement du filament: depart lent 40 mm a 6 mm/s puis 35 mm/s (accel 30), firmware v1.17
    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
2026-10-14 Chargement du filament: +50 mm (rapide 880 mm, total 920 mm), firmware v1.18
    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
2026-10-14 Dechargement du filament: 30 mm/s, accel 30, firmware v1.19
    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
2026-10-14 Chargement +30 mm (rapide 910, total 950), dechargement +80 mm (1000), EXTRUDE_MAXLENGTH 1100, firmware v1.20
    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
2026-10-14 Offset de sonde Z -1.12 (reglage de la 1re couche), DELTA_HEIGHT 312.22, firmware v1.21
    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
2026-10-14 Arret auto de la buse apres 10 min d'inactivite, pause de changement de filament 240 s, firmware v1.22
    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
2026-10-15 FILAMENT_CHANGE_RESUME_ON_INSERT: chargement automatique a l'insertion du filament, firmware v1.23
    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
2026-10-15 Menu Tests (1ere couche, filament) integre au firmware + chargement automatique au repos, firmware v1.24
    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
2026-10-15 Test de premiere couche en spirale (une seule ligne + rond plein)
    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
2026-10-15 Maillage du plateau (G29 bilineaire 7x7) avant chaque impression, spirale au pas de 8 mm, firmware v1.25
    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
2026-10-15 Test courroies (StallGuard des 3 moteurs, M122 S1) : G-code, script serie, entree du menu Tests, firmware v1.26
    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
2026-10-15 Courroies : StallGuard moyen des 3 tours affiche sur l'ecran (patch tmc_util.cpp), SG_RESULT dans M122 S1 sur TMC2209, firmware v1.27
    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
2026-10-15 Menu Tests : supprime le saut de ligne final des G-codes (static_assert de Marlin), firmware v1.28
    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
2026-10-15 Courroies : affichage rafraichi toutes les 2 s (l'ecran se decalait a 4 Hz), resultat final aussi sur le port serie, firmware v1.29
    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
2026-10-15 Courroies : retour a l'ecran d'info a la fin du test pour afficher le resultat, firmware v1.30
    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
2026-10-15 NO_SD_DETECT : plus de message Media init fail au demarrage (carte via Actualiser media), firmware v1.31
    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
2026-10-15 Menu Tests : Test spirale ajoute, les tests qui extrudent refusent de demarrer sans filament, firmware v1.33
    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
2026-10-15 Ecran courroies : etat EN COURS/FINI fiable, plus de retour a l'ecran d'info a la fin du test, firmware v1.34
    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
2026-10-15 Ecran courroies : compteurs de diagnostic (n mesures, rafraichissements, rapport actif), M122 S0 au debut du test, firmware v1.35
    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
2026-10-15 Courroies : EN COURS efface seulement par une vraie fin de test, lancement avec confirmation, firmware v1.36
    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
2026-10-15 Spirale de premiere couche reduite a 75 mm de rayon (fichier docs/test_spirale_r75.gcode)
    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
2026-10-15 Spirale de premiere couche de 65 mm de rayon (docs/test_spirale_r65.gcode)
    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
2026-10-15 Spirale 75 mm lente (10 mm/s) pour diagnostiquer la deformation du cote Y
    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
2026-10-15 Spirale 75 mm sans maillage (diagnostic cote Y)
    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
2026-10-15 Zone palpee elargie a 77 mm (PROBING_MARGIN 20), firmware v1.37
    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
2026-10-15 Fichier de balayage de la hauteur du plateau (13 G30)
    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
2026-10-16 Ecran qui bugue dans le menu SD : tri/cache de la liste en RAM, REINIT_NOISY_LCD, reinit ecran a l'entree (v1.38)
    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
2026-10-16 Neva-v1.38.zip : les 3 fichiers modifies de la v1.38
    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
2026-10-16 Dossier seul dans la liste SD pris pour un fichier : correctif cardreader.cpp (v1.39)
    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
2026-10-16 Impr. depuis la SD remonte la carte a chaque ouverture (plus d'Actualiser obligatoire) (v1.40)
    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
2026-10-16 Fichier SD : 'Imprimer' selectionne d'office a la confirmation (v1.41)
    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
2026-10-16 Palpage plus lent : approche 30 mm/s, mesure 5 mm/s (v1.43)
    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
2026-10-16 Menu Calibration auto (G28+G33+M500) et reglages PrusaSlicer (v1.45)
    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
2026-10-16 Reimprimer le meme fichier a la fin de l'impression (v1.46)
    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
2026-10-16 La buse chauffe pendant le homing et le palpage (v1.48)
    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
2026-10-16 G33 calibre sur un cercle de 67 mm (PROBING_MARGIN 10) (v1.49)
    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
2026-10-16 Maillage G29 elargi a 85 mm (NEVA_MESH_MARGIN) (v1.50)
    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
2026-10-16 Bip plus fort et reinitialisation de l'ecran apres une operation (v1.51)
    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
2026-10-16 Test du papier (hauteur de buse comparee aux 5 points avec maillage)
    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
2026-10-16 Maillage lu avec le decalage de la sonde (NEVA_MESH_SHIFT) (v1.52)
    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
2026-10-16 Correctif G29 : borne avant du maillage -77 mm (v1.53)
    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
2026-10-16 Test des 5 carres (1re couche aux 5 endroits)
    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
2026-10-16 Spirale de 85 mm avec corrections du maillage
2026-10-16 Palpage plus rapide : mesure 8 mm/s, degagement 3 mm (v1.58)
    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
2026-10-16 Entree 'Imprimer le dernier' (fichier le plus recent de la racine) (v1.59)
    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
2026-10-16 Spirale de sensibilite (bord droit remonte volontairement)
2026-10-16 Corrections du maillage : bord droit 0,00 (I5 -0,12), d'apres le test de sensibilite
2026-10-16 Spirale des 3 tours exterieurs seulement
2026-10-18 v1.60 : version du firmware sous le logo de demarrage
    make_bootscreen.py lit NEVA_FW_VERSION dans Configuration.h et la grave dans _Bootscreen.h.
    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
2026-10-18 v1.61 : message d'accueil avec la version du firmware
    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
2026-10-18 v1.62 : en palpage la buse reste a moins de 95 mm du centre (tete touche le pilier)
    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
2026-10-18 v1.63 : palpage plus court (MULTIPLE_PROBING 2), la tete remonte a 30 mm apres G29
    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
2026-10-18 v1.64 : defilement des noms de fichiers longs dans le menu SD
    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
2026-10-18 v1.65 : M73 PrusaSlicer, arret d'urgence, defilement des messages, menu Sons, fondu du maillage, annuler objet, rappel courroies
    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
2026-10-18 v1.66 : retrait de la limite de portee de la buse en palpage (G29 sortait en out of bounds depuis la v1.62)
    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
2026-10-18 Logo de demarrage regenere avec v1.66 (oubli depuis la v1.61)
    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
2026-10-18 Spirale 3 lignes sans corrections M421 (mesure du maillage seul apres le travail sur les poulies)
    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
2026-10-18 Spirale 3 lignes avec corrections droite/avant (essai apres les poulies)
    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
2026-10-18 Test du centre : spirale de rayon 26 mm
    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
2026-10-18 Carte des zones du plateau (secteurs 1-8, anneaux A/B, centre C) avec les noeuds du maillage
    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
2026-10-18 Outil : zones du plateau collees en transparence sur une photo de spirale
    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
2026-10-18 Spirale complete essai 8 (bord de 1A remonte : I6 J3/J4 -0,15)
    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
2026-10-18 Tests : la buse reste chaude a la fin (spirales et test du centre)
    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
2026-10-18 v1.67 : M851 Z -1.195 par defaut, forme de plateau (coin BMG exclu), corrections M421 de l'essai 11 dans le profil PrusaSlicer
    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
2026-10-18 M851 Z -1.233 par defaut et dans le profil PrusaSlicer (babystep de l'utilisateur)
    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
2026-10-18 Profil PrusaSlicer pour la Neva (imprimante + filament PLA)
    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
2026-10-18 Fiche de suivi pour reprendre le projet (etat v1.67, defaut connu, prochaine experience)
    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
2026-10-18 Suivi : piste du bord de la feuille triangulaire (sonde hors feuille cote BMG)
    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
2026-10-19 v1.68 : G29 saute les coins du maillage hors de la feuille (|X|>80 et Y>10)
    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
2026-10-19 v1.69 : zone de palpage reduite pour la feuille triangulaire, G33 R10, plateau PrusaSlicer a trois cotes
    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
2026-10-19 v1.70 : retour a la regle simple (noeuds X +/-85 Y>10), plateau 190 mm, G33 R10 ; v1.69 abandonnee
    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
2026-10-19 v1.71 : PROBING_MARGIN 14.5 (sonde limitee a 85,5 mm : echecs a 89,2 et 89,6 mm), G33 standard, regle des noeuds retiree
    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
2026-10-19 v1.72 : Calibration auto = G33 R10 (la sonde atteignait 85,5 mm au point arriere de G33)
    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
2026-10-19 Calibration auto = G33 R20 (sonde a 65,5 mm du centre au plus)
    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
2026-10-19 Palpage reporte sur la photo de la plaque (decalage de la sonde pris en compte)
    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
2026-10-19 Palpage sur la photo : centre ajuste sur le rond imprime
    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
2026-10-19 Palpage sur la photo : rond de 198 mm ajuste
    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
2026-10-19 Palpage sur la photo : deux cercles candidats A (198,2 mm) et B (200 mm)
    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
2026-10-19 Palpage sur la photo : centre = cercle B valide par l'utilisateur
    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
2026-10-19 v1.73 : bloc Plaque Neva (mesures de la photo), NEVA_PROBE_MAX_RADIUS 85.5 pilote PROBING_MARGIN
    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
2026-10-19 v1.74 : rayon max de la sonde 75 mm, Calibration auto = G33 simple
    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
2026-10-19 Suivi: etat v1.74 (Calibration auto OK)
    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
2026-10-19 v1.75: G29 ne refuse plus ses bornes (good_bounds ne verifie que la buse)
    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
2026-10-19 v1.75: sonde jusqu'a 82 mm, Calibration auto = G33 R7
    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
2026-10-19 Zone de la sonde calculee avec le contour de la feuille (arriere en fleche) : zone_fleche.py/png
    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
2026-10-19 v1.76: sonde jusqu'a 90 mm (33 noeuds), Calibration auto = G33 R15
    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
2026-10-19 probe.h: refuse les points ou la buse touche les tours X/Y (r > 94 mm, +-30 deg) - pas encore empaquete
    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
2026-10-19 v1.76: sonde a 88 mm (29 noeuds), Calibration auto = G33 R13, tours evitees
    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
2026-10-19 Schema sonde/buse v1.76 (cercle 88 mm, tours)
    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
2026-10-19 v1.76: sonde 88,5 mm (31 noeuds), tours a 98 mm, G33 R13.5
    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
2026-10-19 Profil PrusaSlicer: retire les 19 M421 de l'ancien maillage (v1.76)
    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
