poy74fl/Neva/(notices)

Notices in the files:
marlin-patches/Marlin/src/module/probe.h:
This program is free software: you can redistribute it and/or modify
it under the terms of the GNU General Public License as published by
the Free Software Foundation, either version 3 of the License, or
(at your option) any later version.
marlin-config/Configuration_adv.h:
define TOUCH_UI_UTF8_COPYRIGHT // © ®
